incredibleMachines/cameraPi/piFirmware/utils/README.txt

/*

PI CANNON
=========

version: RC2

---

*IP ADDYS*

trigger:  192.168.0.3:1234

local camera API:80
download: 192.168.0.2:3001

browser:  192.168.0.4

---

*/
