incredibleMachines/cameraPi/eagle/v1.5/piBackpack.brd

## EAGLE design eagle/v1.5/piBackpack.brd (2014-08-20, an earlier design)

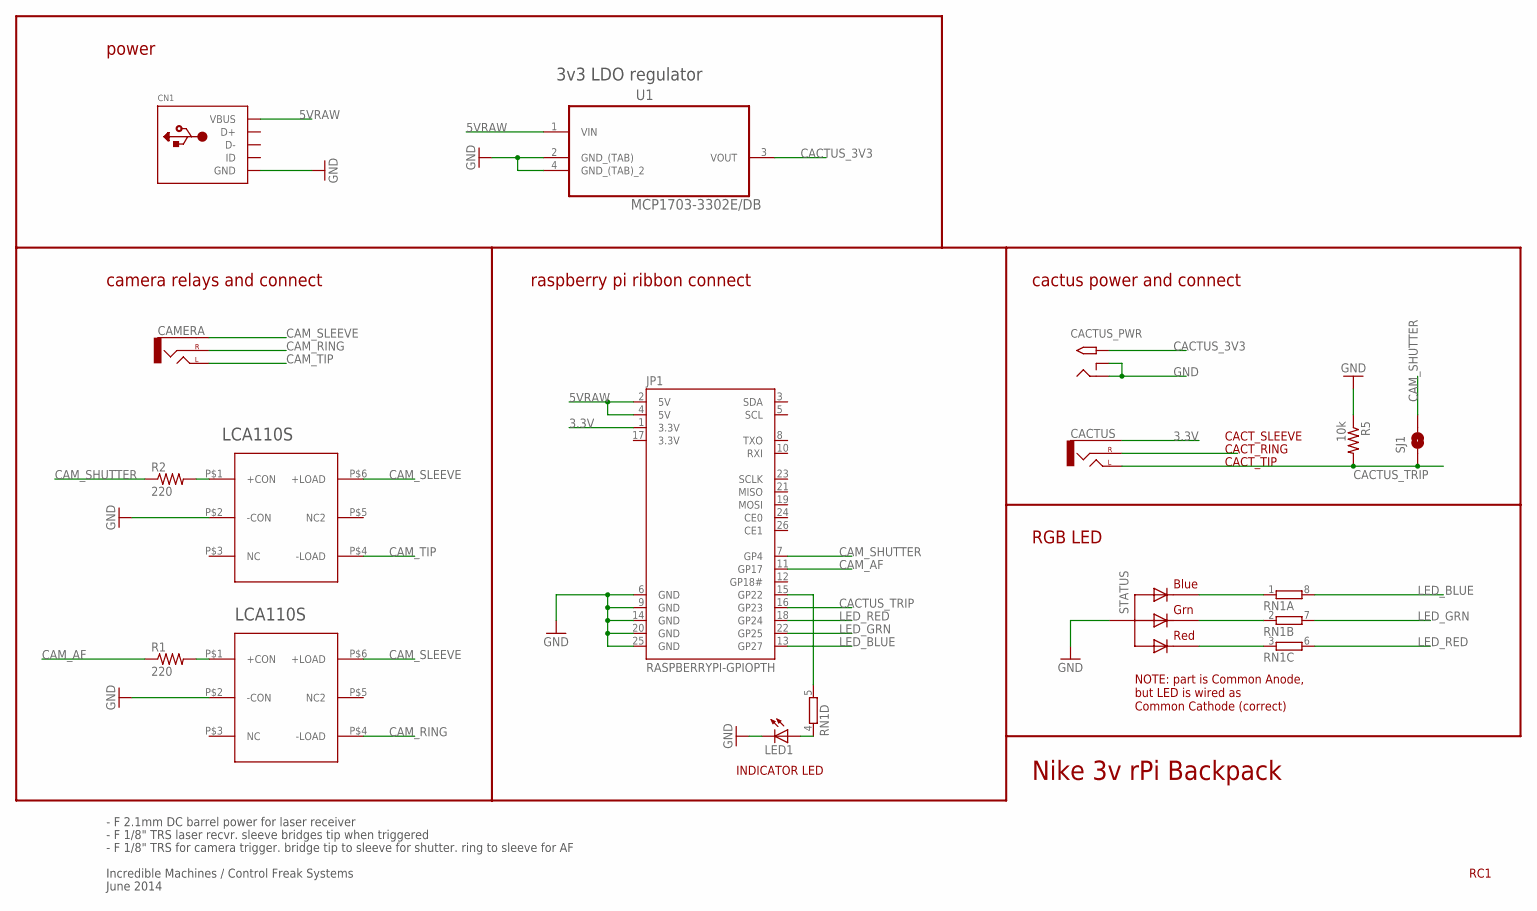
[picture p1: schematic piBackpack.sch]

Parts:
CACTUS: AUDIO-JACKPTH; AUDIO-JACK
CACTUS_PWR: 2.1MMJACKTHM; PJ-102A
CAMERA: AUDIO-JACKPTH; AUDIO-JACK
CN1: USBMOLEX; USB-MINIB-THM-MOLEX
JP1: RASPBERRYPI-GPIOPTH; 2X13-SHROUDED
LCA110S, LCA110S1: LCA110S; 6-SMD
LED1: LED3MM
R1, R2: 220; 0204/5
R5: 10k; 0204/5
RN1: 4R-NEXBS8V; EXBS8V
SJ1: SOLDERJUMPER-OLDNO; SJ_2S-NO
STATUS: RGBLED_CA-5MM; LED5MMRGB
U1: MCP1703-3302E/DB; SOT230P700X180-4N

Connections:
3.3V: CACTUS.SLEEVE, JP1.1 (3.3V), JP1.17 (3.3V)
5VRAW: CN1.VBUS, JP1.2 (5V), JP1.4 (5V), U1.1 (VIN)
CACTUS_3V3: CACTUS_PWR.TIP, U1.3 (VOUT)
CACTUS_TRIP: CACTUS.TIP (LEFT), JP1.16 (GP23), R5.2, SJ1.1
CACT_RING: CACTUS.RING (RIGHT)
CAM_AF: JP1.11 (GP17), R1.1
CAM_RING: CAMERA.RING (RIGHT), LCA110S.P$4 (-LOAD)
CAM_SHUTTER: JP1.7 (GP4), R2.1, SJ1.2
CAM_SLEEVE: CAMERA.SLEEVE, LCA110S.P$6 (+LOAD), LCA110S1.P$6 (+LOAD)
CAM_TIP: CAMERA.TIP (LEFT), LCA110S1.P$4 (-LOAD)
GND: CACTUS_PWR.RING, CACTUS_PWR.RING_SW, CN1.GND, JP1.6 (GND), JP1.9 (GND), JP1.14 (GND), JP1.20 (GND), JP1.25 (GND), LCA110S.P$2 (-CON), LCA110S1.P$2 (-CON), LED1.K (C), R5.1, STATUS.2 (VCC), U1.2 (GND_(TAB)), U1.4 (GND_(TAB)_2)
LED_BLUE: JP1.13 (GP27), RN1.8 (2)
LED_GRN: JP1.22 (GP25), RN1.7 (2)
LED_RED: JP1.18 (GP24), RN1.6 (2)
unnamed: RN1.1, STATUS.4 (BLUE)
unnamed: RN1.2 (1), STATUS.3 (GREEN)
unnamed: RN1.3 (1), STATUS.1 (RED)
unnamed: JP1.15 (GP22), RN1.5 (2)
unnamed: LED1.A, RN1.4 (1)
unnamed: LCA110S.P$1 (+CON), R1.2
unnamed: LCA110S1.P$1 (+CON), R2.2

Notes on the sheet:
Nike 3v rPi Backpack
Incredible Machines / Control Freak Systems
June 2014
- F 2.1mm DC barrel power for laser receiver
- F 1/8" TRS laser recvr. sleeve bridges tip when triggered
- F 1/8" TRS for camera trigger. bridge tip to sleeve for shutter. ring to sleeve for AF
CACT_SLEEVE
CACT_TIP
CACT_RING
NOTE: part is Common Anode, but LED is wired as Common Cathode (correct)
raspberry pi ribbon connect
camera relays and connect
RGB LED
cactus power and connect
RC1
INDICATOR LED
power
3v3 LDO regulator
LCA110S

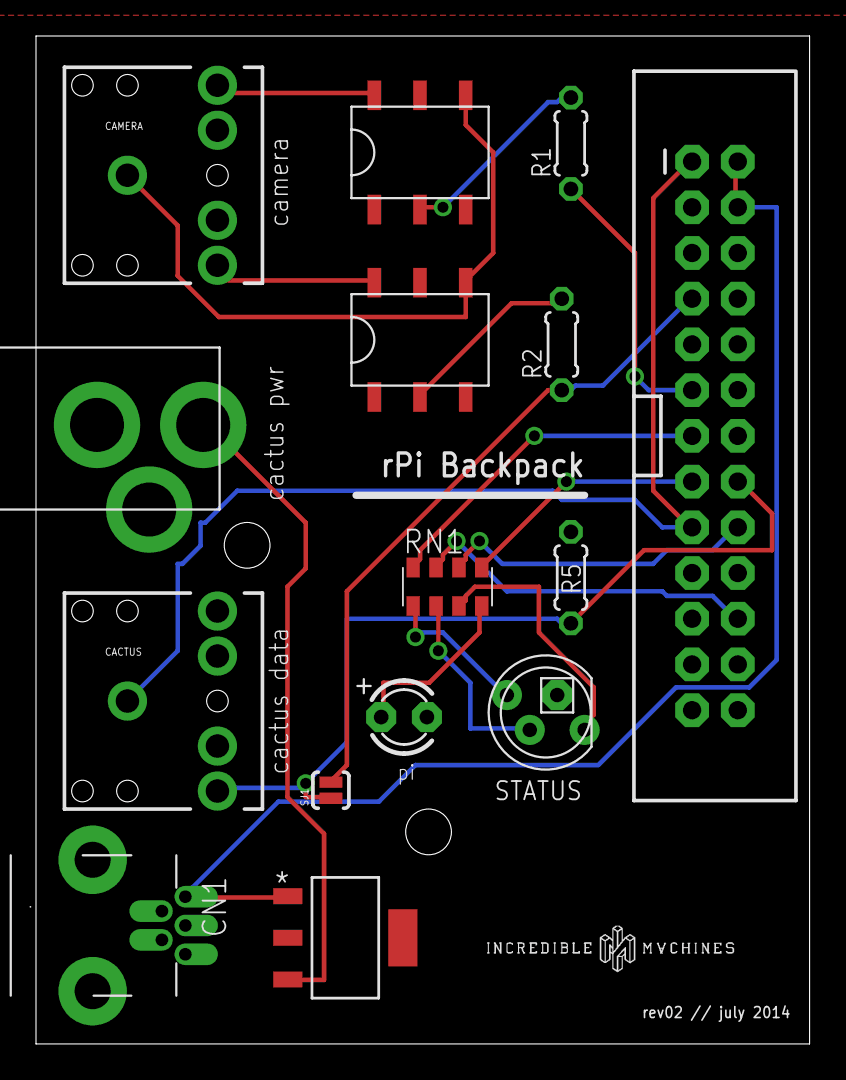
[picture p2: board piBackpack.brd from above]

Board: 2 copper layers, 43.0 x 56.0 mm, 15 parts (0 on the bottom side), 20 nets.
