incredibleMachines/cameraPi/eagle/v1.0/nike_relay.brd

## EAGLE design eagle/v1.0/nike_relay.brd (2014-06-07, an earlier design)

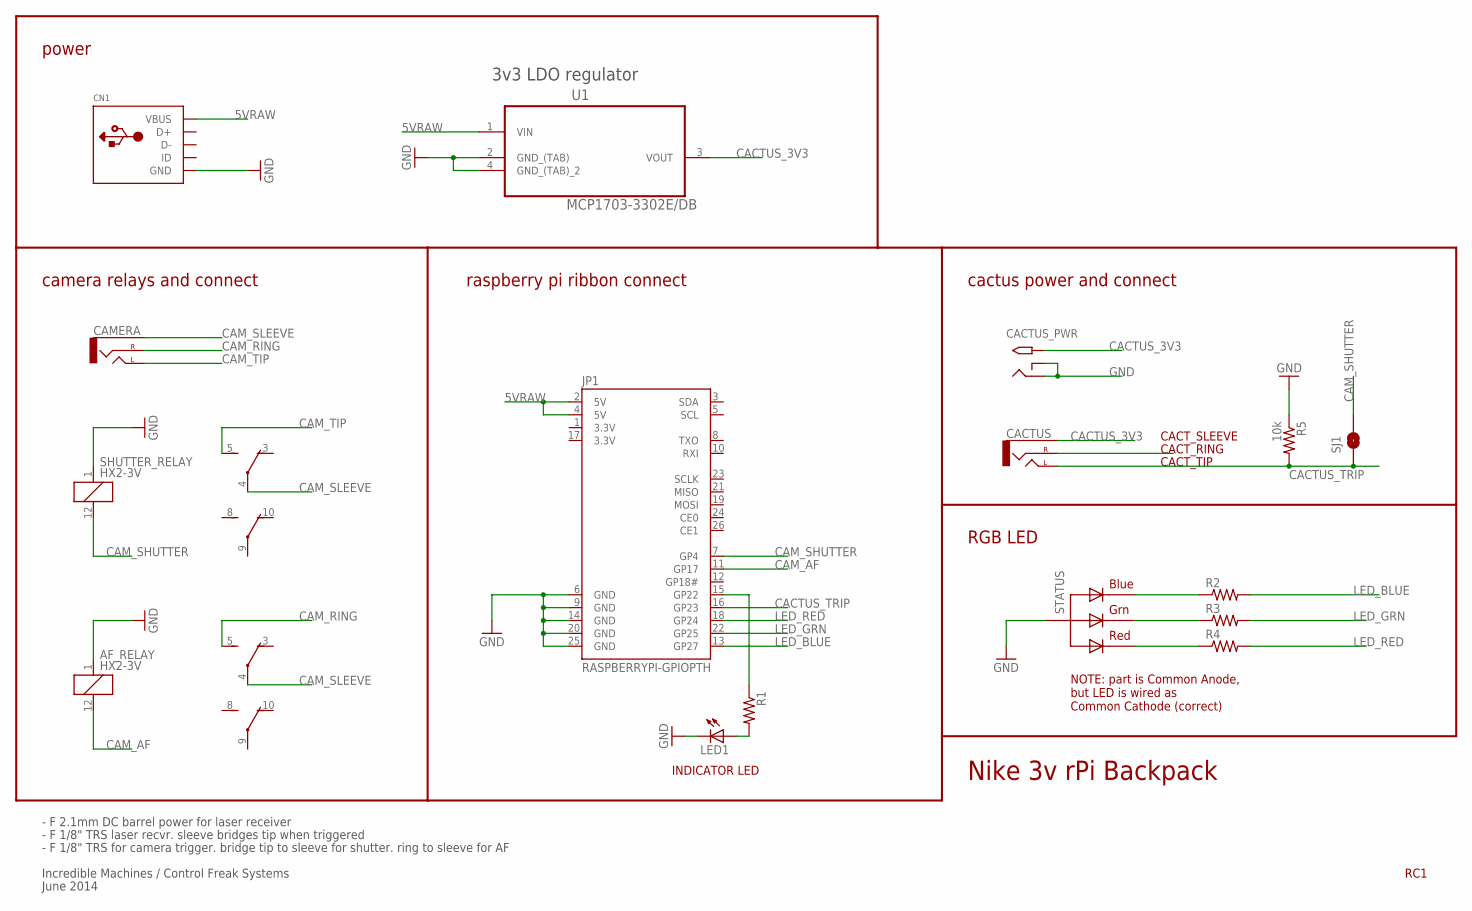
[picture p3: schematic nike_relay.sch]

Parts:
AF_RELAY: HX2-3V; HX
CACTUS: AUDIO-JACKPTH; AUDIO-JACK
CACTUS_PWR: 2.1MMJACKTHM; PJ-102A
CAMERA: AUDIO-JACKPTH; AUDIO-JACK
CN1: USBMOLEX; USB-MINIB-THM-MOLEX
JP1: RASPBERRYPI-GPIOPTH; 2X13-SHROUDED
LED1: LED3MM
R1, R2, R3, R4: R-US_0204/5; 0204/5
R5: 10k; 0204/5
SHUTTER_RELAY: HX2-3V; HX
SJ1: SOLDERJUMPER-OLDNO; SJ_2S-NO
STATUS: RGBLED_CA-5MM; LED5MMRGB
U1: MCP1703-3302E/DB; SOT230P700X180-4N

Connections:
3.3V: JP1.1 (3.3V), JP1.17 (3.3V)
5VRAW: CN1.VBUS, JP1.2 (5V), JP1.4 (5V), U1.1 (VIN)
CACTUS_3V3: CACTUS.SLEEVE, CACTUS_PWR.TIP, U1.3 (VOUT)
CACTUS_TRIP: CACTUS.TIP (LEFT), JP1.16 (GP23), R5.2, SJ1.1
CACT_RING: CACTUS.RING (RIGHT)
CAM_AF: AF_RELAY.12 (2), JP1.11 (GP17)
CAM_RING: AF_RELAY.5 (S), CAMERA.RING (RIGHT)
CAM_SHUTTER: JP1.7 (GP4), SHUTTER_RELAY.12 (2), SJ1.2
CAM_SLEEVE: AF_RELAY.4, CAMERA.SLEEVE, SHUTTER_RELAY.4
CAM_TIP: CAMERA.TIP (LEFT), SHUTTER_RELAY.5 (S)
GND: AF_RELAY.1, CACTUS_PWR.RING, CACTUS_PWR.RING_SW, CN1.GND, JP1.6 (GND), JP1.9 (GND), JP1.14 (GND), JP1.20 (GND), JP1.25 (GND), LED1.K (C), R5.1, SHUTTER_RELAY.1, STATUS.2 (VCC), U1.2 (GND_(TAB)), U1.4 (GND_(TAB)_2)
LED_BLUE: JP1.13 (GP27), R2.2
LED_GRN: JP1.22 (GP25), R3.2
LED_RED: JP1.18 (GP24), R4.2
unnamed: R2.1, STATUS.4 (BLUE)
unnamed: R3.1, STATUS.3 (GREEN)
unnamed: R4.1, STATUS.1 (RED)
unnamed: JP1.15 (GP22), R1.1
unnamed: LED1.A, R1.2

Notes on the sheet:
Nike 3v rPi Backpack
Incredible Machines / Control Freak Systems
June 2014
- F 2.1mm DC barrel power for laser receiver
- F 1/8" TRS laser recvr. sleeve bridges tip when triggered
- F 1/8" TRS for camera trigger. bridge tip to sleeve for shutter. ring to sleeve for AF
CACT_SLEEVE
CACT_TIP
CACT_RING
NOTE: part is Common Anode, but LED is wired as Common Cathode (correct)
raspberry pi ribbon connect
camera relays and connect
RGB LED
cactus power and connect
RC1
INDICATOR LED
power
3v3 LDO regulator

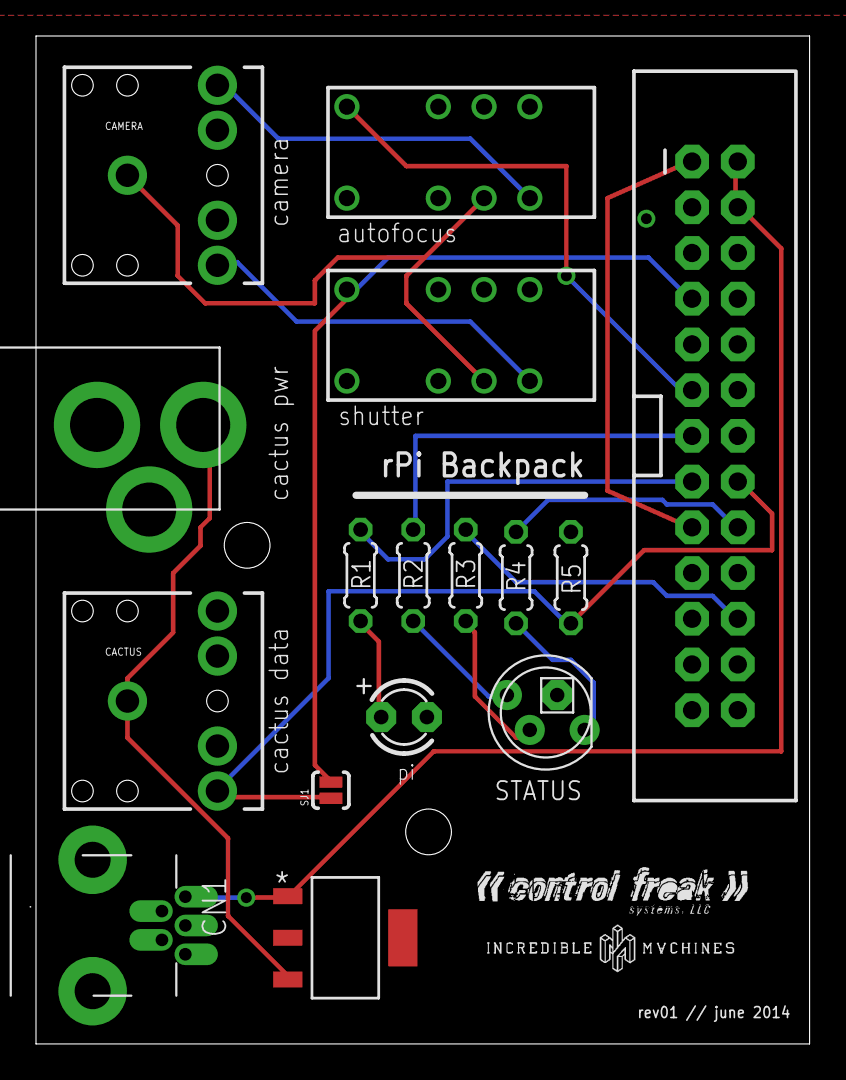
[picture p4: board nike_relay.brd from above]

Board: 2 copper layers, 43.0 x 56.0 mm, 16 parts (0 on the bottom side), 18 nets.
