incredibleMachines/cameraPi/eagle/v1.9/DSLR_controller.brd

## EAGLE design eagle/v1.9/DSLR_controller.brd (2014-08-20)

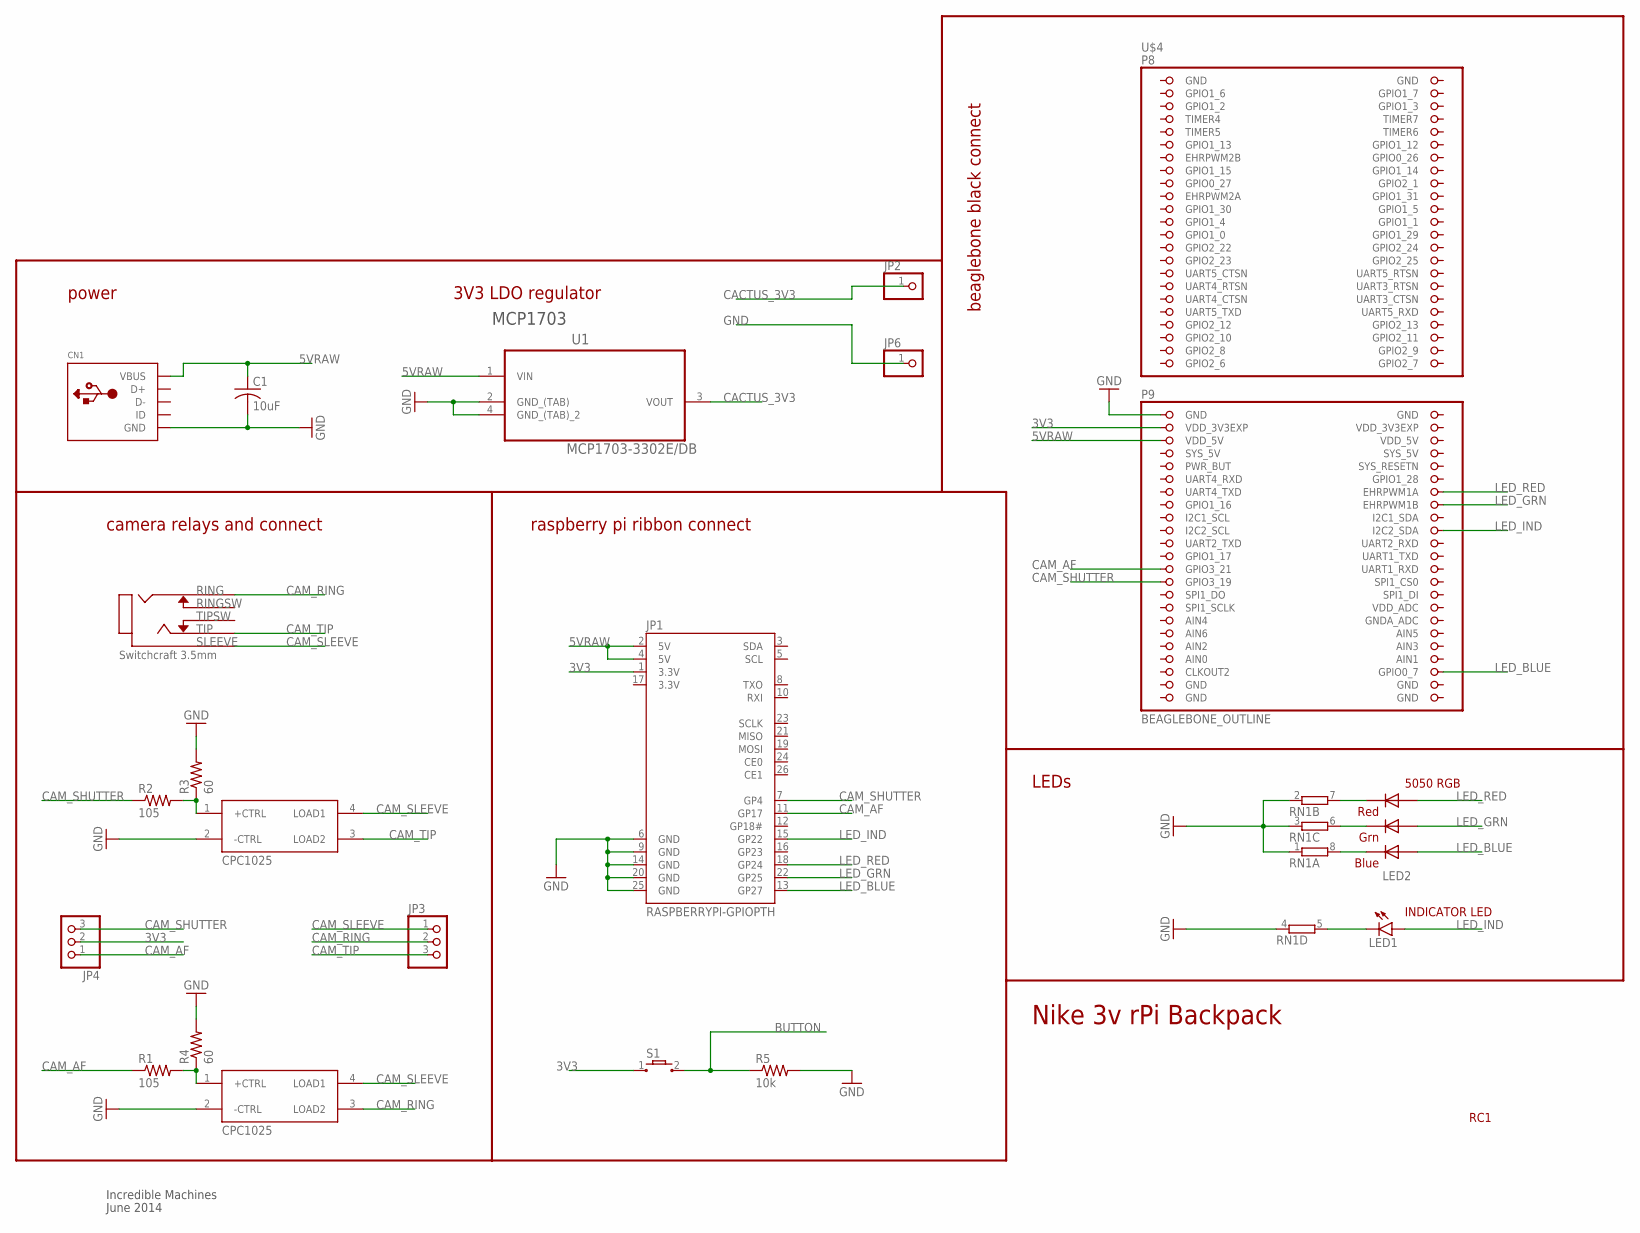
[picture p5: schematic DSLR_controller.sch]

Parts:
C1: 10uF; C1206K
CN1: USBMOLEX; USB-MINIB-THM-MOLEX
JP1: RASPBERRYPI-GPIOPTH; 2X13-SHROUDED
JP2, JP6: PINHD-1X1CB; 1X01-CLEANBIG
JP3, JP4: PINHD-1X3CB; 1X03-CLEANBIG
LED1: LED1206; LED-1206
LED2: RGBLED5050
R1, R2: 105; R1206
R3, R4: 60; R1206
R5: 10k; R1206
RN1: 4R-NEXBS8V; EXBS8V
S1: TL3302-G; TL3302_GULL_WING
U1: MCP1703-3302E/DB; SOT230P700X180-4N
U$1: SWTCHCRFT_3.5JACK5-JACK-SMD; 4-JACK-SMD
U$2, U$3: CPC1025_OPTORELAY; 4-OPTORELAY
U$4: BEAGLEBONE_OUTLINE; BEAGLEBONE_SHIELD

Connections:
3.3V: JP1.17 (3.3V)
3V3: JP1.1 (3.3V), JP4.2, S1.1, U$4.49 (VDD_3V3EXP)
5VRAW: C1.1, CN1.VBUS, JP1.2 (5V), JP1.4 (5V), U1.1 (VIN), U$4.51 (VDD_5V)
AIN0: U$4.85 (AIN0)
BUTTON: R5.1, S1.2
CACTUS_3V3: JP2.1, U1.3 (VOUT)
CAM_AF: JP1.11 (GP17), JP4.1, R1.1, U$4.71 (GPIO3_21)
CAM_RING: JP3.2, U$1.2, U$2.3 (LOAD2)
CAM_SHUTTER: JP1.7 (GP4), JP4.3, R2.1, U$4.73 (GPIO3_19)
CAM_SLEEVE: JP3.1, U$1.1, U$2.4 (LOAD1), U$3.4 (LOAD1)
CAM_TIP: JP3.3, U$1.3, U$3.3 (LOAD2)
GND: C1.2, CN1.GND, JP1.6 (GND), JP1.9 (GND), JP1.14 (GND), JP1.20 (GND), JP1.25 (GND), JP6.1, R3.2, R4.2, R5.2, RN1.1, RN1.2 (1), RN1.3 (1), RN1.4 (1), U1.2 (GND_(TAB)), U1.4 (GND_(TAB)_2), U$2.2 (-CTRL), U$3.2 (-CTRL), U$4.1 (GND), U$4.2 (GND), U$4.47 (GND), U$4.48 (GND), U$4.89 (GND), U$4.90 (GND), U$4.91 (GND), U$4.92 (GND)
LED_BLUE: JP1.13 (GP27), LED2.3 (BLUE_A), U$4.88 (GPIO0_7)
LED_GRN: JP1.22 (GP25), LED2.1 (GREEN_A), U$4.62 (EHRPWM1B)
LED_IND: JP1.15 (GP22), LED1.A, U$4.66 (I2C2_SDA)
LED_RED: JP1.18 (GP24), LED2.2 (RED_A), U$4.60 (EHRPWM1A)
unnamed: LED2.6 (GREEN_C), RN1.6 (2)
unnamed: LED2.5 (RED_C), RN1.7 (2)
unnamed: LED2.4 (BLUE_C), RN1.8 (2)
unnamed: LED1.C, RN1.5 (2)
unnamed: R1.2, R4.1, U$2.1 (+CTRL)
unnamed: R2.2, R3.1, U$3.1 (+CTRL)
SYS_5V: U$4.53 (SYS_5V)
VDD_3V3EXP: U$4.50 (VDD_3V3EXP)
VDD_5V: U$4.52 (VDD_5V)

Notes on the sheet:
Nike 3v rPi Backpack
Incredible Machines
June 2014
raspberry pi ribbon connect
camera relays and connect
LEDs
RC1
INDICATOR LED
power
MCP1703
beaglebone black connect
5050 RGB
3V3 LDO regulator

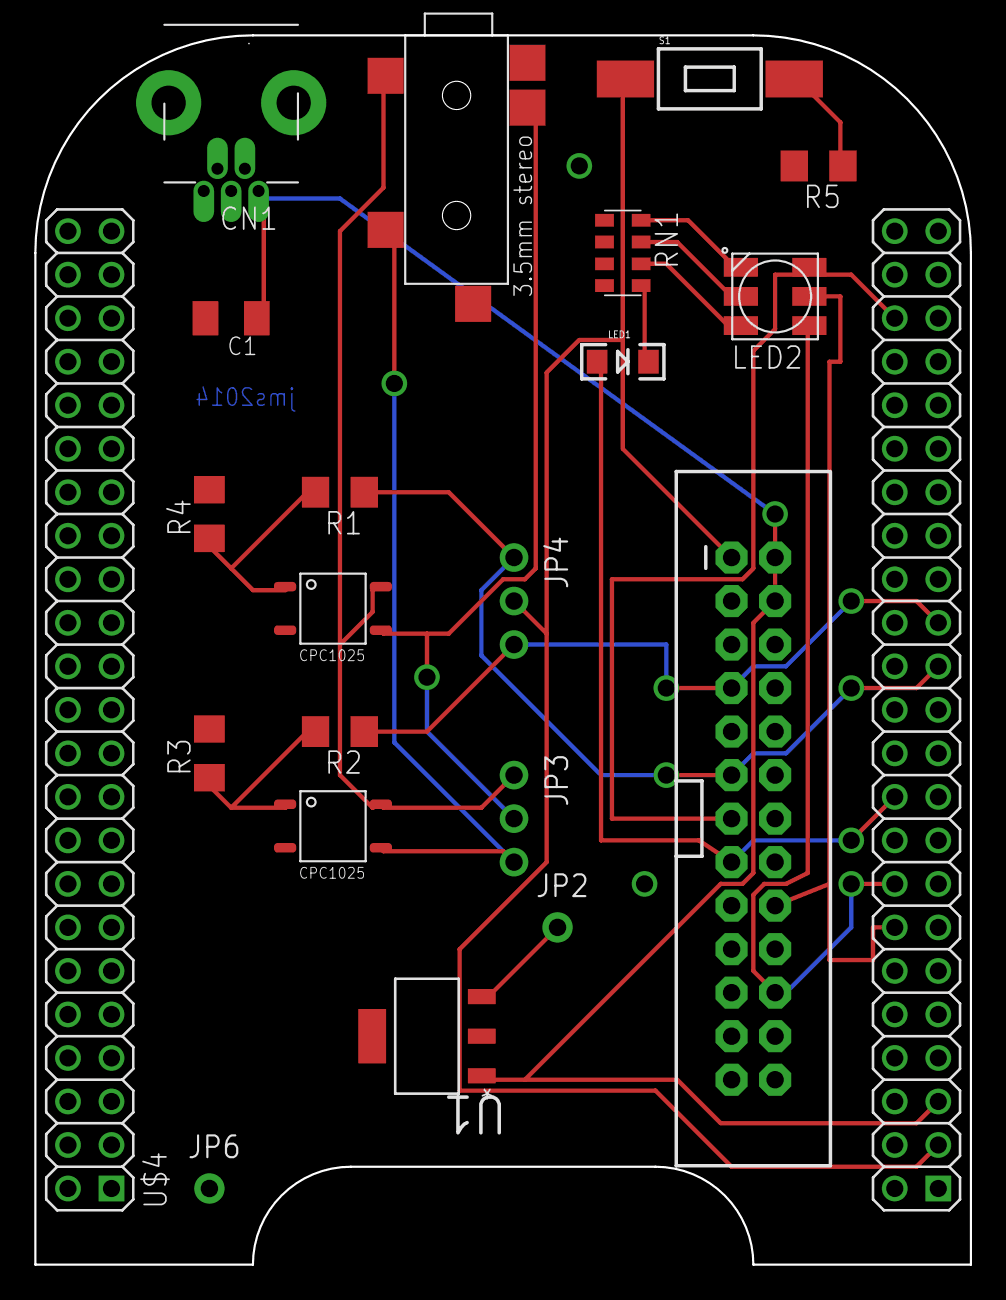
[picture p6: board DSLR_controller.brd from above]

Board: 2 copper layers, 54.6 x 71.8 mm, 21 parts (0 on the bottom side), 20 nets.
