incredibleMachines/cameraPi/pi_code/laser/laser.js

/*LASER.JS

  Test to do ALL GPIO FUNCTIONALITY

  - Laser INPUT pin
*/


var Gpio = require('onoff').Gpio;
var WebSocket = require('ws') //*******
var os = require('os')
var fs = require('fs')
var exec = require('child_process').exec
var ws = new WebSocket('ws://169.254.233.80:1234');//**********

//all should be configured to OUT except for pin 23.
var PIN = [23, 24, 27, 25];

for(var i=0; i<PIN.length; i++){
  var strExec; //string to execute
  if(i<1) strExec = 'gpio export '+PIN[i]+ ' in';
  else strExec = 'gpio export '+PIN[i]+ ' out';

  var child = exec(strExec,function(error,stdout,stderr){
    if(error) console.log("GPIO ERROR: "+error);
  })
}


//*** VARS
var groupLeader = true;
var triggerState = 0; //prevent false triggers
var triggerBufferTime = 1500; //how long to wait before next trigger


//*** PINS
var PIN_LASER     = new Gpio(PIN[0], 'in', 'rising');//'both');
var PIN_LED_RED   = new Gpio(PIN[3], 'out');
var PIN_LED_GRN   = new Gpio(PIN[1], 'out');
var PIN_LED_BLUE  = new Gpio(PIN[2], 'out');
var standbyLed    = PIN_LED_GRN;

setTimeout(function(){
   configLaser(groupLeader); //config as default
 },1000); //wait a second for Gpio(pin) to config first


var networkInterfaces = os.networkInterfaces() //*************
console.log(networkInterfaces)

var ipAddress = '';
if(networkInterfaces.hasOwnProperty('eth0')){
  ipAddress = networkInterfaces.eth0[0].address
}else{
  ipAddress = 'undefined'
}

// ** OPEN WEBSOCKET **
ws.on('open', function() {
  var obj = {'address':ipAddress}
  console.log(obj)
  ws.send(JSON.stringify(obj));
});


//** WEBSOCKET MESSAGE HANDLING **
ws.on('message', function(data, flags) {

  if(data == 'close'){
    var child = exec('echo raspberry | sudo shutdown -h now',function(error,stdout,stderr){
      console.log('stdout: '+stdout)
      console.log('stderr: '+stderr)
    })
  }

  else if(data == 'toggleleader'){
    configLaser(!groupLeader);
  }
});

//** CONFIGURE LASER **
//can be set through /toggleleader route currently
function configLaser(job){
  groupLeader = job;
  digitalWrite(standbyLed, 0);

  if(groupLeader){ //watch sensor!

    //** set watch with callback on laserpin RISING
    PIN_LASER.watch(function(err, value) {
        //console.log("LASER TRIP RISING DETECTED");
        laserTriggered();
    });
    console.log(">> Running Laser.js, configured as GROUP LEADER <<");
    standbyLed = PIN_LED_GRN;
  }

  else{
    PIN_LASER.unwatch(function(err){
      if (err) throw err;
    })
    console.log(">> Laser.js configured as GROUP MEMBER <<")
    standbyLed = PIN_LED_BLUE;
  }

  digitalWrite(standbyLed, 1); //standby LED on
}


//** what to do when a laser trip is detected **
function laserTriggered(){
  if(!triggerState){ //make sure we don't trigger a bunch of times in a row
    console.log("trip detected, triggering NOW");

    //TODO: SEND TRIGGER OBJECT TO SERVER HERE

    triggerState = true;
    digitalWrite(PIN_LED_RED, 1);
    digitalWrite(standbyLed, 0);

    setTimeout(function(){
       triggerState = false; //reset trigger
       digitalWrite(PIN_LED_RED, 0);
       digitalWrite(standbyLed, 1);
     },triggerBufferTime); //how long to wait between tiggers
   } else {
     console.log("trip detected during wait time");
   }
}


//** digitalWrite function
function digitalWrite(pin, state){
  pin.write(state, function(err) { // Asynchronous write.
    //pin.write(value === 0 ? 1 : 0, function(err) {
      if (err) throw err;
  });
}


//** close on quit
process.on('SIGINT', function() {
  console.log(' Got SIGINT closing gpio');
  digitalWrite(PIN_LED_GRN, 0);
  digitalWrite(PIN_LED_RED, 0);
  digitalWrite(PIN_LED_BLUE, 0);
  console.log(' Goodbye ');
  process.exit(0)
})
