incredibleMachines/cameraPi/(commit log)

2014-06-07 added all eagle files for rPi backpack
    [nike_relay.brd, nike_relay.sch]
2014-06-07 Various Changes still in beta form - image downloading, camera control, gpio functionality
    Beta state for various server implimentations listed below. All these files are super ugly and need lots of work, don't judge.
    CameraControl to sync w. camera via usb and listen for changes in order to capture images and post to download server.
    Download to receive images via express to process and name files as they come into our server.
    Minor mods to gpio2.js
2014-06-07 enabling download and trigger apps to run concurrently, modifying camera controls to support this functionality
2014-06-07 created laser prototype folder
2014-06-08 laser functionality proven. run node laser.js to see laser hit shutter pin and light LED when triggered. Trigger buffer time implemented.
2014-06-08 Rearranging folder structures adding camera http server functionality
2014-06-08 reformatting naming of laser trigger
2014-06-08 Initial browser commit App for sending out camera settings
2014-06-08 adding in captureAll.js - a test to try all GPIO pin activity using asynchronous interrupts. package.json now includes onoff package
2014-06-08 Working drop downs for all camera settings
2014-06-08 Adding support for Camera API http server and Capture EOSSerialCapture and report
    This code still needs to test the http posting etc once the browser app is ready to rock. additionally still needs camera wake up functionality
2014-06-08 updated laser.js to use onoff, captureALL test added, packages all include onoff now
2014-06-08 fixing capture to run after get is recieved
    [capture.js]
2014-06-08 Camera Management
    P C# Please enter the commit message for your changes. Lines starting
2014-06-08 Working Camera naming off MongoDB
2014-06-08 port switch to 80
2014-06-08 RC2 - pi_code
    all correct IP addresses in (show addys)
    updated camera, capture, laser files, packages
    refactored folders
    [camera.js, capture.js]
2014-06-09 Arm call /arm posts camera info _id, camera_id, address, serial :wq
2014-06-09 Sending get request for setting camera values
2014-06-09 Working check for ip changes, new serial numbers on camera sign on
2014-06-09 quick fix to limit multiple socket connections
    [capture.js]
2014-06-09 Working camera settings for testing
2014-06-09 Changed pi route to '/camera'
2014-06-09 updated camera.js to use GPIO lib to control AF pin for waking the camera up on startup and serialID failure
    [camera.js]
2014-06-09 adding git pull functionality to camera, adding gitpull.sh script
2014-06-09 Working database Correct database queries and calls for all timing and camera settings, has laser data in camera object :wq
2014-06-10 readding camera.js
2014-06-10 camera.js fix
2014-06-11 Adding Ping functionality to socket server
2014-06-11 added laser test code
2014-06-12 Fixed camel case issue on new info method
2014-06-12 Initial commit of processing_server Working file naming, warping, cropping, variable framerate encoding, and concat Creates four folders - warped, cropped, movs, output Output stores a file with take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
2014-06-13 Working calibration settings saving, checking public folder in downloads for calibration images
2014-06-13 Working calibration public folder setup on processing.js
2014-06-15 Download and Processing Changes Minor changes WIP for calibration mode :wq
2014-06-15 piFirmware RC5.4
    updated reconnect strategy.
    implemented settings file write when settings are updated.
    laser toggle through udp.
    laser enable and local states are recalled on boot up.
2014-06-17 adding cameras/all route, cleaning up settings page to correctly write to the pis api
2014-06-18 important updates to process flow --cp
2014-06-19 Massive updates to system core, browser, download and processing optimizations, syncing with bolster, spawning multiple takes, takes databasing, controller front end views/app flow, calibration states
2014-06-22 confirming sftp curl pull working on system, switching remote route back to correct path
2014-08-20 added several board revisions
    [DSLR_controller.brd, DSLR_controller.sch, nike_relay.brd, nike_relay.sch, piBackpack.brd, piBackpack.sch]
